tukavic/Computer-Project/images/ALU_6_one_72.jpg

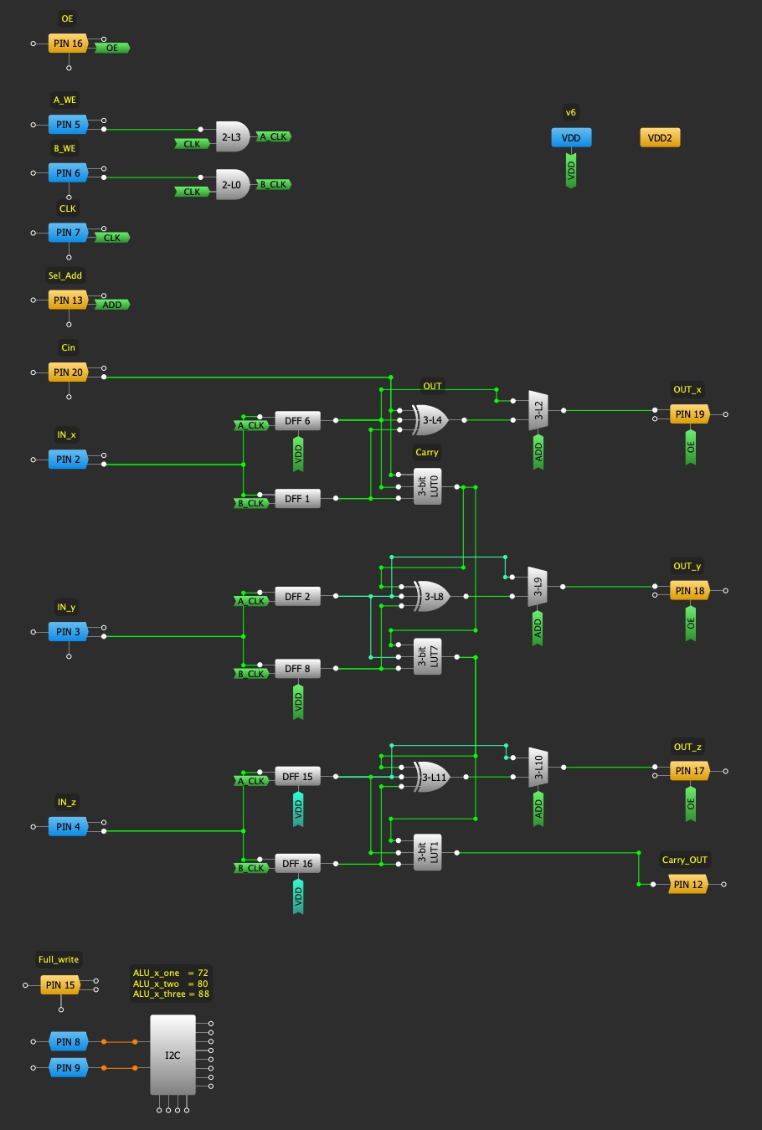
images/ALU_6_one_72.jpg
