tukavic/Computer-Project/opcodes_r007.xlsm

Sheet: Readme
This document works through the ISA
Change log:
r001 - original version
r002 - removed full byte pvalues in favor of including that data in the instruction
r003 - configured PC/RAM OE to 0 for OUTA (see sheet TTr2)
r004/5 - flipped polarity of RAM OE and WE because its active low
r006 - tried to finalize once I have it working in system. Cleaned up extra sheets
r007 - working towards adding BCH_OUT instruction

Sheet: Task List
Future Additions:
1 | Branching in ISA
2 | An idea to demonstrate capabilities
3 | GPIO expander for Arduino
4 | Add input capabilities to system
5 | cleanup bus routings with magnet wire

Sheet: ISA Truth Table
ISA Truth Table: r006 |  |  |  | 2018-07-12
 |  |  |  |  |  |  | 19 | 18 | 17 | 16 | 15 | 13 | 12 | 10
 | 7 | 6 | 5 | 4 | secndry |  |  |  |  |  |  |  | OE's
 | Opcode | Opcode | Opcode | Opcode |  | Full write? | A | B | DP | nRAM | OUT | ADD | RAMn/ALU | PC/DPn
LDa C | 0 | 0 | 1 | 1 | 0 | 0 | 1 | 0 | 0 | 1 | 0 | 0 | 0 | 1
LDa P | 1 | 0 | 1 | 0 | 0 | 0 | 1 | 0 | 1 | 1 | 0 | 0 | 0 | 1
Lda P2 | 1 | 0 | 1 | 0 | 1 | 1 | 1 | 0 | 0 | 1 | 0 | 0 | 0 | 0
LDb C | 0 | 1 | 1 | 1 | 0 | 0 | 0 | 1 | 0 | 1 | 0 | 0 | 0 | 1
LDb P | 1 | 1 | 0 | 0 | 0 | 0 | 0 | 1 | 1 | 1 | 0 | 0 | 0 | 1
LDb P2 | 1 | 1 | 0 | 0 | 1 | 1 | 0 | 1 | 0 | 1 | 0 | 0 | 0 | 0
STa P | 1 | 0 | 0 | 0 | 0 | 0 | 0 | 0 | 1 | 1 | 0 | 0 | 0 | 1
Sta P2 | 1 | 0 | 0 | 0 | 1 | 0 | 0 | 0 | 0 | 0 | 0 | 0 | 1 | 0
Add & STaP | 1 | 1 | 1 | 0 | 0 | 0 | 0 | 0 | 1 | 1 | 0 | 1 | 0 | 1
Add & STaP2 | 1 | 1 | 1 | 0 | 1 | 0 | 0 | 0 | 0 | 0 | 0 | 1 | 1 | 0
OUTA | 0 | 1 | 1 | 0 | 0 | 0 | 0 | 0 | 0 | 1 | 1 | 0 | 1 | 1
NOP | 0 | 0 | 0 | 1 | 0 | 0 | 0 | 0 | 0 | 1 | 0 | 0 | 0 | 1
 |  |  |  |  |  | 1 | 0 | 0 | 0 | 1 | 0 | 0 | 0 | 0
##This seems to be working in system (7/12), a minor problem with pointers still

Sheet: ISA TT
Control Signals
Executes Defined | PC_CLK? | WE? | OE? |  | Instruction SET Inputs:
LDa C |  |  |  | IO/s | 8 | 7 | 6 | 5 | 4 | 3 | 2 | 1
Inst | Clk PC | A | PC, RAM |  | Opcode | Opcode | Opcode | Opcode | Const | Const | Const | Const |  | ID#
 |  |  |  | LDa C | 0 | 0 | 1 | 1 | C | C | C | C |  | 3
LDa P |  |  |  | LDa P | 1 | 0 | 1 | 0 | x | P | P | P |  | 10
Inst | No Clk PC | DP | PC, RAM | LDb C | 0 | 1 | 1 | 1 | C | C | C | C |  | 7
WE_a | Clk PC | A | RAM,DP | LDb P | 1 | 1 | 0 | 0 | x | P | P | P |  | 12
 |  |  |  | STa P | 1 | 0 | 0 | 0 | x | P | P | P |  | 8
LDb C |  |  |  | Add & STaP | 1 | 1 | 1 | 0 | x | P | P | P |  | 14
Inst | Clk PC | B | PC, RAM | OUTA | 0 | 1 | 1 | 0 | x | x | x | x |  | 6
 |  |  |  | NOP | 0 | 0 | 0 | 1 | 0 | 0 | 0 | 0 |  | 1
LDb P
Inst | No Clk PC | DP | PC, RAM
WE_b | Clk PC | B | RAM,DP |  | One if pointer follows |  |  | One if Constant follows
STa P |  |  |  | ISA Truth Table: r007 |  |  |  | 2019-10-10
Inst | No Clk PC | DP | PC, RAM |  |  |  |  |  |  |  | 19 | 18 | 17 | 16 | 15 | 13 | 12 | 10 | 7
WE_mem | Clk PC | RAM | A, DP |  | 7 | 6 | 5 | 4 | secndry | WE's |  |  |  |  |  |  | OE's |  | BCHs
 |  |  |  |  | Opcode | Opcode | Opcode | Opcode |  | Full write? | A | B | DP | nRAM | OUT | ADD | RAMn/ALU | PC/DPn | BCH_en
ADD & STa P |  |  |  | LDa C | 0 | 0 | 1 | 1 | 0 | 0 | 1 | 0 | 0 | 1 | 0 | 0 | 0 | 1 | 0
Inst | No Clk PC | DP | PC, RAM | LDa P | 1 | 0 | 1 | 0 | 0 | 0 | 1 | 0 | 1 | 1 | 0 | 0 | 0 | 1 | 0
WE_mem | Clk PC | RAM | DP | Lda P2 | 1 | 0 | 1 | 0 | 1 | 1 | 1 | 0 | 0 | 1 | 0 | 0 | 0 | 0 | 0
 |  |  |  | LDb C | 0 | 1 | 1 | 1 | 0 | 0 | 0 | 1 | 0 | 1 | 0 | 0 | 0 | 1 | 0
OUTA |  |  |  | LDb P | 1 | 1 | 0 | 0 | 0 | 0 | 0 | 1 | 1 | 1 | 0 | 0 | 0 | 1 | 0
Inst | Clk PC | OUT | PC, A | LDb P2 | 1 | 1 | 0 | 0 | 1 | 1 | 0 | 1 | 0 | 1 | 0 | 0 | 0 | 0 | 0
 |  |  |  | STa P | 1 | 0 | 0 | 0 | 0 | 0 | 0 | 0 | 1 | 1 | 0 | 0 | 0 | 1 | 0
 |  |  |  | Sta P2 | 1 | 0 | 0 | 0 | 1 | 0 | 0 | 0 | 0 | 0 | 0 | 0 | 1 | 0 | 0
 |  |  |  | Add & STaP | 1 | 1 | 1 | 0 | 0 | 0 | 0 | 0 | 1 | 1 | 0 | 1 | 0 | 1 | 0
 |  |  |  | Add & STaP2 | 1 | 1 | 1 | 0 | 1 | 0 | 0 | 0 | 0 | 0 | 0 | 1 | 1 | 0 | 0 | Example:
 |  |  |  | OUTA | 0 | 1 | 1 | 0 | 0 | 0 | 0 | 0 | 0 | 1 | 1 | 0 | 1 | 1 | 0 | x = 5
 |  |  |  | NOP | 0 | 0 | 0 | 1 | 0 | 0 | 0 | 0 | 0 | 1 | 0 | 0 | 0 | 1 | 0 | y = 2 + x | where x = 0x10, y = 0x11 | Instruction Memory
 |  |  |  | BCH_OUT | 0 | 1 | 1 | 1 | 0 | 0 | 0 | 0 | 0 | 1 | 0 | 0 | 0 | x | 1 | LDaC = 5 |  | LDaC : 5
 |  |  |  |  |  |  |  |  |  |  |  |  |  |  |  |  |  |  |  | STaP = x |  | STaP:
 |  |  |  |  |  |  |  |  |  |  |  |  |  |  |  |  |  |  |  | LDaP = x |  | X
 |  |  |  |  |  |  |  |  |  |  |  |  |  |  |  |  |  |  |  | LDbC = 2 |  | LDaP:
 |  |  |  |  |  |  | on BCH_OUT, both DP and PC are told by CTRL that Branching is enabled. With this logic, the DP and PC use logic from OUT to determine who drives |  |  |  |  |  |  |  |  |  |  |  |  | ADD&STaP = y |  | X
 |  |  |  |  |  |  |  | if BCH_CTRL from OUT_96 is (X) then DP passes its inputs through while PC turns all outputs into inputs and stores on next clock [this is branching] |  |  |  |  |  |  |  |  |  |  |  |  |  | LDbC: 2
 |  |  |  |  |  |  |  | if BCH_CTRL from OUT_96 is (Y) then DP disables output, PC updates next clock cycle [this is continue] |  |  |  |  |  |  |  |  |  |  |  |  |  | ADD&STaP:
 |  |  |  |  |  |  |  |  |  |  |  |  |  |  |  |  |  |  |  |  |  | Y
 |  |  |  |  |  |  | Need to do
 |  |  |  |  |  |  |  | *update CTRL to have BCH_en signal
 |  |  |  |  |  |  |  | *update OUT to compare its output and wire those signals to PC+DP
 |  |  |  |  |  |  |  | *PC needs to be configured to reverse the pins to input and save a value if told so
 |  |  |  |  |  |  |  | *DP needs logic to buffer inputs if BCH_en and (X)
 |  |  |  |  |  |  |  | *PC needs to set MSB to 0 when BCH_en is active
 |  |  |  |  |  |  |  | *PC needs two additional inputs

Sheet: HLBD
Instructions: Rev1
LDa C
LDa P
LDb C
LDb P
STa P
Add & STaP
OUTA
NOP
Executes Defined | PC_CLK? | WE? | OE?
LDa C
Inst | Clk PC | A | PC, RAM
LDa P
Inst | No Clk PC | DP | PC, RAM
WE_a | Clk PC | A | RAM,DP
LDb C
Inst | Clk PC | B | PC, RAM
LDb P
Inst | No Clk PC | DP | PC, RAM
WE_b | Clk PC | B | RAM,DP
STa P |  |  |  | x = 2
Inst | No Clk PC | DP | PC, RAM | y = 3
WE_mem | Clk PC | RAM | A, DP | z = x + y
ADD & STa P |  |  |  | LDaC = 2
Inst | No Clk PC | DP | PC, RAM | STaP = x
WE_mem | Clk PC | RAM | DP | LDaC = 3
 |  |  |  | STaP = y
OUTA |  |  |  | LDaP = x
Inst | Clk PC | OUT | PC, RAM | LDbP = y
 |  |  |  | A&STaP = z
 |  |  |  | nop…

Sheet: Compiler
LDa_C | 0 | 0000 | 00110000 | Instructions: Rev1
OUTA |  | 0000 | 01100000 | LDa_C
LDa_C | 1 | 0001 | 00110001 | LDa_P
OUTA |  | 0000 | 01100000 | LDb_C
LDa_C | 2 | 0010 | 00110010 | LDb_P
OUTA |  | 0000 | 01100000 | STa_P
LDa_C | 3 | 0011 | 00110011 | ADD_SP
OUTA |  | 0000 | 01100000 | OUTA
LDa_C | 4 | 0100 | 00110100 | NOP
OUTA |  | 0000 | 01100000
LDa_C | 5 | 0101 | 00110101
OUTA |  | 0000 | 01100000
LDa_C | 6 | 0110 | 00110110
OUTA |  | 0000 | 01100000
LDa_C | 7 | 0111 | 00110111
OUTA |  | 0000 | 01100000
LDa_C | 8 | 1000 | 00111000
OUTA |  | 0000 | 01100000
LDa_C | 9 | 1001 | 00111001
OUTA |  | 1010 | 01100000
LDa_C | 10 | 0000 | 00110000
OUTA |  | 1011 | 01100000
LDa_C | 11 | 0000 | 00110000
OUTA |  | 1100 | 01100000
LDa_C | 12 | 0000 | 00110000
OUTA |  | 1101 | 01100000
LDa_C | 13 | 0000 | 00110000
OUTA |  | 1110 | 01100000
LDa_C | 14 | 0000 | 00110000
OUTA |  | 1111 | 01100000
LDa_C | 15 | 0000 | 00110000
 |  | 0000
 |  | 0000
 |  | 0000
 |  | 0000
 |  | 0000
 |  | 0000
 |  | 0000
 |  | 0000
 |  | 0000
 |  | 0000
 |  | 0000
 |  | 0000
 |  | 0000

Sheet: Test Benches
LDa_C | 0 | 0000 | 00110000 | , | 00110000, | B | B00110000, | 48
OUTA |  | 0000 | 01100000 | , | 01100000, | B | B01100000, | 96
LDa_C | 1 | 0001 | 00110001 | , | 00110001, | B | B00110001, | 49
OUTA |  | 0000 | 01100000 | , | 01100000, | B | B01100000, | 96
LDa_C | 2 | 0010 | 00110010 | , | 00110010, | B | B00110010, | 50
OUTA |  | 0000 | 01100000 | , | 01100000, | B | B01100000, | 96
LDa_C | 3 | 0011 | 00110011 | , | 00110011, | B | B00110011, | 51
OUTA |  | 0000 | 01100000 | , | 01100000, | B | B01100000, | 96
LDa_C | 4 | 0100 | 00110100 | , | 00110100, | B | B00110100, | 52
OUTA |  | 0000 | 01100000 | , | 01100000, | B | B01100000, | 96
LDa_C | 5 | 0101 | 00110101 | , | 00110101, | B | B00110101, | 53
OUTA |  | 0000 | 01100000 | , | 01100000, | B | B01100000, | 96
LDa_C | 6 | 0110 | 00110110 | , | 00110110, | B | B00110110, | 54
OUTA |  | 0000 | 01100000 | , | 01100000, | B | B01100000, | 96
LDa_C | 7 | 0111 | 00110111 | , | 00110111, | B | B00110111, | 55
OUTA |  | 0000 | 01100000 | , | 01100000, | B | B01100000, | 96
LDa_C | 8 | 1000 | 00111000 | , | 00111000, | B | B00111000, | 56
OUTA |  | 0000 | 01100000 | , | 01100000, | B | B01100000, | 96
LDa_C | 9 | 1001 | 00111001 | , | 00111001, | B | B00111001, | 57
OUTA |  |  | 01100000 | , | 01100000, | B | B01100000, | 96
LDa_C | 10 | 1010 | 00111010 | , | 00111010, | B | B00111010, | 58
OUTA |  | 0000 | 01100000 | , | 01100000, | B | B01100000, | 60
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
LDa_C |  | 0110 | 00110110 | , | 00110110, | B | B00110110, //LDa_C | 36 | 54 | 8
STa_P |  | 0001 | 10000001 | , | 10000001, | B | B10000001, //STa_P | 81 | 129 | 9
LDa_P |  | 0001 | 10100001 | , | 10100001, | B | B10100001, //LDa_P | A1 | 161 | 10
OUTA |  | 0000 | 01100000 | , | 01100000, | B | B01100000, //OUTA | 60 | 96 | 11
LDa_C |  | 0011 | 00110011 | , | 00110011, | B | B00110011, //LDa_C | 33 | 51 | 12
STa_P |  | 0001 | 10000001 | , | 10000001, | B | B10000001, //STa_P | 81 | 129 | 13
LDa_P |  | 0001 | 10100001 | , | 10100001, | B | B10100001, //LDa_P | A1 | 161 | 14
OUTA |  | 0000 | 01100000 | , | 01100000, | B | B01100000, //OUTA | 60 | 96 | 15
LDa_C |  | 0101 | 00110101 | , | 00110101, | B | B00110101, //LDa_C | 35 | 53 | 16
STa_P |  | 0001 | 10000001 | , | 10000001, | B | B10000001, //STa_P | 81 | 129 | 17
LDa_P |  | 0001 | 10100001 | , | 10100001, | B | B10100001, //LDa_P | A1 | 161 | 18
OUTA |  | 0000 | 01100000 | , | 01100000, | B | B01100000, //OUTA | 60 | 96 | 19

Sheet: TT r2
ISA Truth Table: r002 |  |  |  | 2018-02-06
 |  |  |  |  |  | 20 | 19 | 18 | 17 | 16 | 15 | 13 | 12 | 10 | 7
 | 7 | 6 | 5 | 4 | secndry | WE's |  |  |  |  |  |  | OE's
 | Opcode | Opcode | Opcode | Opcode |  | PC | A | B | DP | RAM | OUT | ADD | PC/RAM | DP | A
LDa C | 0 | 0 | 1 | 1 | 0 | 1 | 1 | 0 | 0 | 0 | 0 | 0 | 1 | 0 | 0
LDa P | 1 | 0 | 1 | 0 | 0 | 0 | 1 | 0 | 1 | 0 | 0 | 0 | 1 | 0 | 0
Lda P2 | 1 | 0 | 1 | 0 | 1 | 1 | 1 | 0 | 0 | 0 | 0 | 0 | 1 | 1 | 0
LDb C | 0 | 1 | 1 | 1 | 0 | 1 | 0 | 1 | 0 | 0 | 0 | 0 | 1 | 0 | 0
LDb P | 1 | 1 | 0 | 0 | 0 | 0 | 0 | 1 | 1 | 0 | 0 | 0 | 1 | 0 | 0
LDb P2 | 1 | 1 | 0 | 0 | 1 | 1 | 0 | 1 | 0 | 0 | 0 | 0 | 1 | 1 | 0
STa P | 1 | 0 | 0 | 0 | 0 | 0 | 0 | 0 | 1 | 0 | 0 | 0 | 1 | 0 | 0
Sta P2 | 1 | 0 | 0 | 0 | 1 | 1 | 0 | 0 | 0 | 1 | 0 | 0 | 0 | 1 | 1
Add & STaP | 1 | 1 | 1 | 0 | 0 | 0 | 0 | 0 | 1 | 0 | 0 | 1 | 1 | 0 | 0
Add & STaP2 | 1 | 1 | 1 | 0 | 1 | 1 | 0 | 0 | 0 | 1 | 0 | 1 | 0 | 1 | 1
OUTA | 0 | 1 | 1 | 0 | 0 | 1 | 0 | 0 | 0 | 0 | 1 | 0 | 1 | 0 | 1
NOP | 0 | 0 | 0 | 1 | 0 | 1 | 0 | 0 | 0 | 0 | 0 | 0 | 1 | 0 | 0
 |  |  |  |  |  |  |  |  |  |  | Had to clear because we don’t want ALU driving while RAM is also driving.
 |  |  |  |  |  |  |  |  |  |  | Could have solid shorts to GND. Who knows what that could cause

Sheet: TT r3
ISA Truth Table: r003 |  |  |  | 2018-04-03
 |  |  |  |  |  | 20 | 19 | 18 | 17 | 16 | 15 | 13 | 12 | 10 | 7
 | 7 | 6 | 5 | 4 | secndry | WE's |  |  |  |  |  |  | OE's
 | Opcode | Opcode | Opcode | Opcode |  | PC | A | B | DP | RAM | OUT | ADD | PC/RAM | DP | A
LDa C | 0 | 0 | 1 | 1 | 0 | 1 | 1 | 0 | 0 | 0 | 0 | 0 | 1 | 0 | 0
LDa P | 1 | 0 | 1 | 0 | 0 | 0 | 1 | 0 | 1 | 0 | 0 | 0 | 1 | 0 | 0
Lda P2 | 1 | 0 | 1 | 0 | 1 | 1 | 1 | 0 | 0 | 0 | 0 | 0 | 1 | 1 | 0
LDb C | 0 | 1 | 1 | 1 | 0 | 1 | 0 | 1 | 0 | 0 | 0 | 0 | 1 | 0 | 0
LDb P | 1 | 1 | 0 | 0 | 0 | 0 | 0 | 1 | 1 | 0 | 0 | 0 | 1 | 0 | 0
LDb P2 | 1 | 1 | 0 | 0 | 1 | 1 | 0 | 1 | 0 | 0 | 0 | 0 | 1 | 1 | 0
STa P | 1 | 0 | 0 | 0 | 0 | 0 | 0 | 0 | 1 | 0 | 0 | 0 | 1 | 0 | 0
Sta P2 | 1 | 0 | 0 | 0 | 1 | 1 | 0 | 0 | 0 | 1 | 0 | 0 | 0 | 1 | 1
Add & STaP | 1 | 1 | 1 | 0 | 0 | 0 | 0 | 0 | 1 | 0 | 0 | 1 | 1 | 0 | 0
Add & STaP2 | 1 | 1 | 1 | 0 | 1 | 1 | 0 | 0 | 0 | 1 | 0 | 1 | 0 | 1 | 1
OUTA | 0 | 1 | 1 | 0 | 0 | 1 | 0 | 0 | 0 | 0 | 1 | 0 | 0 | 0 | 1
NOP | 0 | 0 | 0 | 1 | 0 | 1 | 0 | 0 | 0 | 0 | 0 | 0 | 1 | 0 | 0
 |  |  |  |  |  |  |  |  |  |  | Had to clear because we don’t want ALU driving while RAM is also driving.
 |  |  |  |  |  |  |  |  |  |  | Could have solid shorts to GND. Who knows what that could cause
